medlabprojects/MCB_Daughterboard_ESCON-24-2/Daughter_ESCON_24-2.brd

## EAGLE design Daughter_ESCON_24-2.brd (2019-08-14)

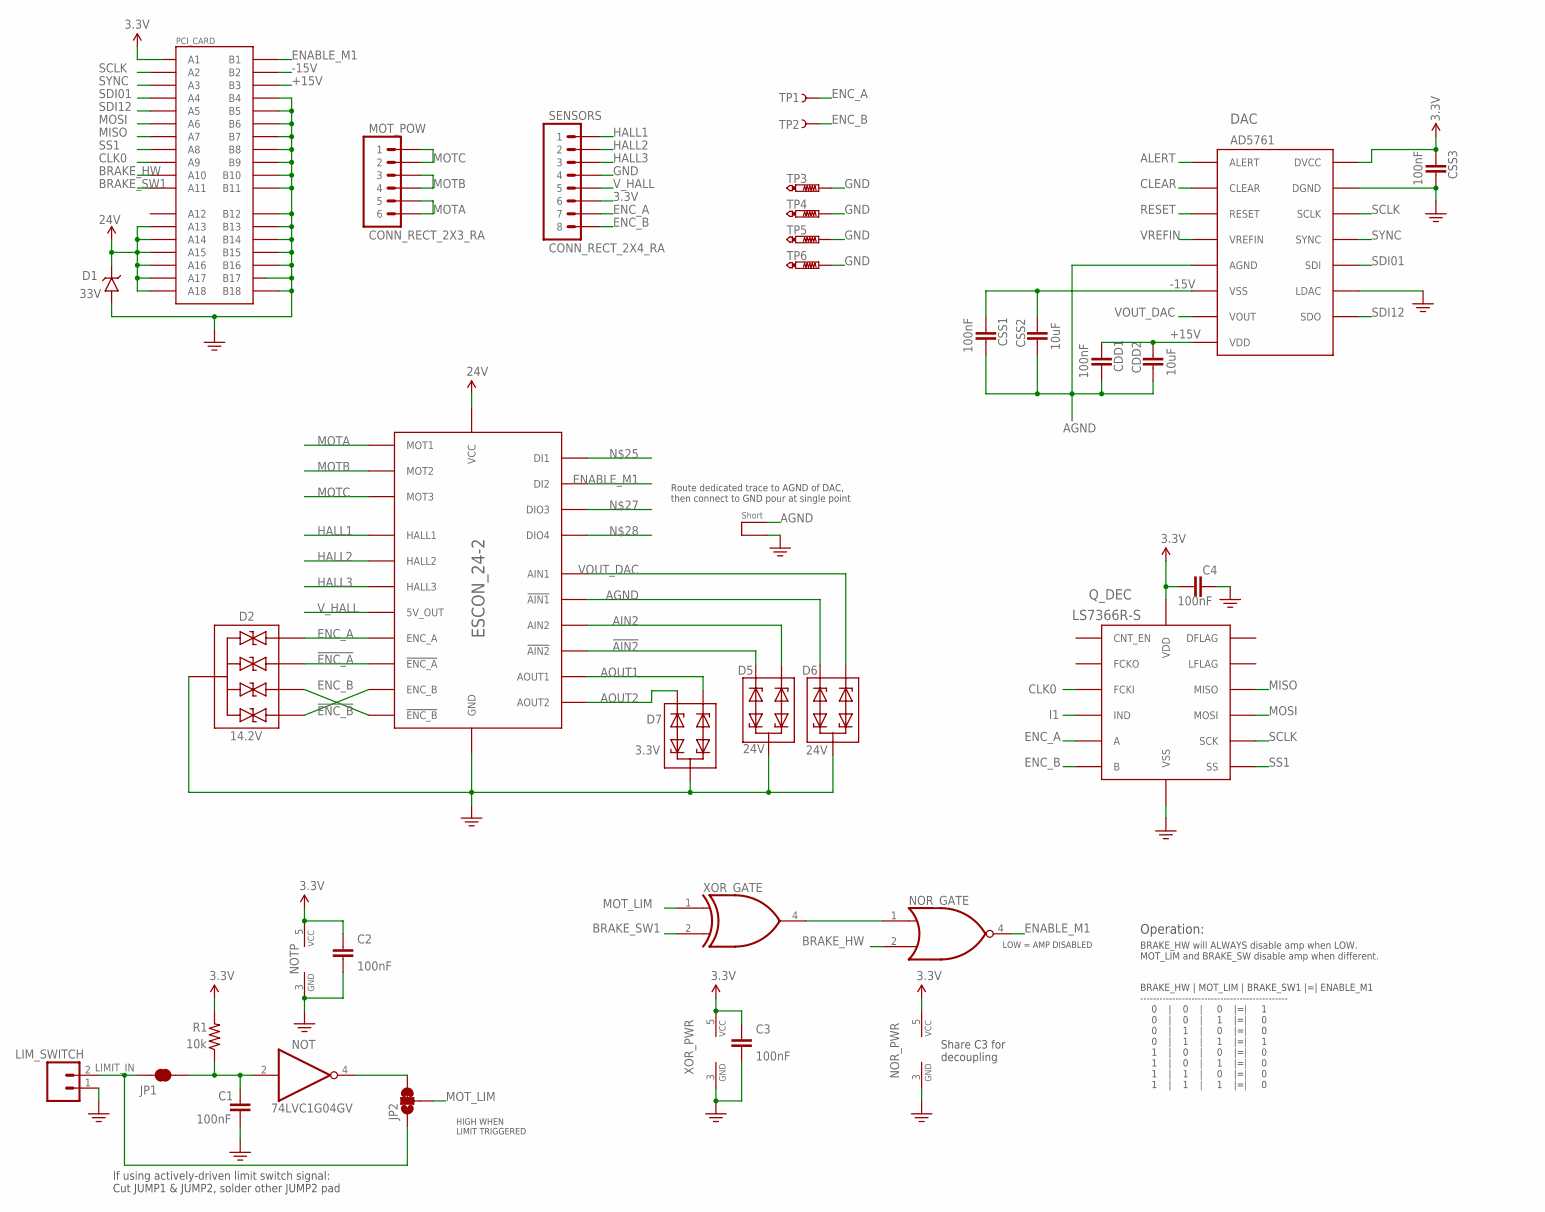
[picture p1: schematic Daughter_ESCON_24-2.sch]

Parts:
C1, C2, C3, C4: 100nF; 0603-CAP
CDD1: 100nF; 0603-CAP
CDD2: 10uF; C0805K
CSS1, CSS3: 100nF; 0603-CAP
CSS2: 10uF; C0805K
D1: 33V; DO214AA
D2: 14.2V; SOTFL50P160X60-6
D5, D6: 24V; SOT95P230X110-3
D7: 3.3V; SOT95P230X110-3
DAC: AD5761; TSSOP16
ESCON_24-2: ESCON_MODULE24-2_BOTTOM_ENTRY; ESCON_24-2_BOTTOM_ENTRY
JP1: JUMPER-PAD-2-NC_BY_TRACE; PAD-JUMPER-2-NC_BY_TRACE_YES_SILK
JP2: JUMPER-PAD-3-2OF3_NC_BY_TRACE; PAD-JUMPER-3-2OF3_NC_BY_TRACE_YES_SILK_FULL_BOX
LIM_SWITCH: 22-05-7028-02; 7395-02
MOT_POW: CONN_RECT_2X3_RA; 2X3-RA
NOR: NOR-SOT353; SOT353
NOT: 74LVC1G04GV; SOT23-5
PCI_CARD: PCIE-36-EDGE
Q_DEC: LS7366R-S; SOIC-14
R1: 10k; 0603-RES
SENSORS: CONN_RECT_2X4_RA; 2X4-RA
TP1, TP2: TEST-POINT_5021
TP3, TP4, TP5, TP6: PTR1TP20R; TP20R
U$1: SHORT
XOR: XOR-SOT353; SOT353

Connections:
3.3V: C2.1, C3.1, C4.1, CSS3.1, DAC.15 (DVCC), NOR.5 (VCC), NOT.5 (VCC), PCI_CARD.A1, Q_DEC.14 (VDD), R1.2, SENSORS.6, XOR.5 (VCC)
24V: D1.C, ESCON_24-2.P$4 (VCC), PCI_CARD.A13, PCI_CARD.A14, PCI_CARD.A15, PCI_CARD.A16, PCI_CARD.A17, PCI_CARD.A18
!AIN2: D5.1 (2), ESCON_24-2.P$21 (!AIN2)
!ENC_A: D2.3 (IO2), ESCON_24-2.P$11 (!ENC_A)
!ENC_B: D2.4 (IO3), ESCON_24-2.P$13 (!ENC_B)
+15V: CDD1.1, CDD2.1, DAC.8 (VDD), PCI_CARD.B3
-15V: CSS1.1, CSS2.1, DAC.6 (VSS), PCI_CARD.B2
AGND: CDD1.2, CDD2.2, CSS1.2, CSS2.2, D6.1 (2), DAC.5 (AGND), ESCON_24-2.P$23 (!AIN1), U$1.P$1
AIN2: D5.2 (1), ESCON_24-2.P$22 (AIN2)
ALERT: DAC.1 (ALERT)
AOUT1: D7.2 (1), ESCON_24-2.P$20 (AOUT1)
AOUT2: D7.1 (2), ESCON_24-2.P$19 (AOUT2)
BRAKE_HW: NOR.2 (B), PCI_CARD.A10
BRAKE_SW1: PCI_CARD.A11, XOR.2 (B)
CLEAR: DAC.2 (CLEAR)
CLK0: PCI_CARD.A9, Q_DEC.2 (FCKI)
ENABLE_M1: ESCON_24-2.P$16 (DI2), NOR.4 (Y), PCI_CARD.B1
ENC_A: D2.1 (IO1), ESCON_24-2.P$10 (ENC_A), Q_DEC.12 (A), SENSORS.7, TP1.P$1
ENC_B: D2.6 (IO4), ESCON_24-2.P$12 (ENC_B), Q_DEC.11 (B), SENSORS.8, TP2.P$1
GND: C1.2, C2.2, C3.2, C4.2, CSS3.2, D1.A, D2.2 (GND), D2.5 (GND), D5.3, D6.3, D7.3, DAC.11 (LDAC), DAC.16 (DGND), ESCON_24-2.P$5 (GND), ESCON_24-2.P$18 (GND), LIM_SWITCH.1, NOR.3 (GND), NOT.3 (GND), PCI_CARD.B4, PCI_CARD.B5, PCI_CARD.B6, PCI_CARD.B7, PCI_CARD.B8, PCI_CARD.B9, PCI_CARD.B10, PCI_CARD.B11, PCI_CARD.B12, PCI_CARD.B13, PCI_CARD.B14, PCI_CARD.B15, PCI_CARD.B16, PCI_CARD.B17, PCI_CARD.B18, Q_DEC.3 (VSS), SENSORS.4, TP3.TP, TP4.TP, TP5.TP, TP6.TP, U$1.P$2, XOR.3 (GND)
HALL1: ESCON_24-2.P$7 (HALL1), SENSORS.1
HALL2: ESCON_24-2.P$8 (HALL2), SENSORS.2
HALL3: ESCON_24-2.P$9 (HALL3), SENSORS.3
I1: Q_DEC.10 (IND)
LIMIT_IN: JP1.1, JP2.1, LIM_SWITCH.2
MISO: PCI_CARD.A7, Q_DEC.6 (MISO)
MOSI: PCI_CARD.A6, Q_DEC.7 (MOSI)
MOTA: ESCON_24-2.P$1 (MOT1), MOT_POW.5, MOT_POW.6
MOTB: ESCON_24-2.P$2 (MOT2), MOT_POW.3, MOT_POW.4
MOTC: ESCON_24-2.P$3 (MOT3), MOT_POW.1, MOT_POW.2
MOT_LIM: JP2.2, XOR.1 (A)
unnamed: C1.1, JP1.2, NOT.2 (I), R1.1
unnamed: JP2.3, NOT.4 (O)
unnamed: NOR.1 (A), XOR.4 (Y)
RESET: DAC.3 (RESET)
SCLK: DAC.14 (SCLK), PCI_CARD.A2, Q_DEC.5 (SCK)
SDI01: DAC.12 (SDI), PCI_CARD.A4
SDI12: DAC.10 (SDO), PCI_CARD.A5
SS1: PCI_CARD.A8, Q_DEC.4 (SS)
SYNC: DAC.13 (SYNC), PCI_CARD.A3
VOUT_DAC: D6.2 (1), DAC.7 (VOUT), ESCON_24-2.P$24 (AIN1)
VREFIN: DAC.4 (VREFIN)
V_HALL: ESCON_24-2.P$6 (5V_OUT), SENSORS.5

Notes on the sheet:
HIGH WHEN LIMIT TRIGGERED
LOW = AMP DISABLED
Operation:
BRAKE_HW will ALWAYS disable amp when LOW. MOT_LIM and BRAKE_SW disable amp when different.
BRAKE_HW | MOT_LIM | BRAKE_SW1 |=| ENABLE_M1 ---------------------------------------------- 0 | 0 | 0 |=| 1 0 | 0 | 1 |=| 0 0 | 1 | 0 |=| 0 0 | 1 | 1 |=| 1 1 | 0 | 0 |=| 0 1 | 0 | 1 |=| 0 1 | 1 | 0 |=| 0 1 | 1 | 1 |=| 0
If using actively-driven limit switch signal: Cut JUMP1 & JUMP2, solder other JUMP2 pad
Route dedicated trace to AGND of DAC, then connect to GND pour at single point
Share C3 for decoupling

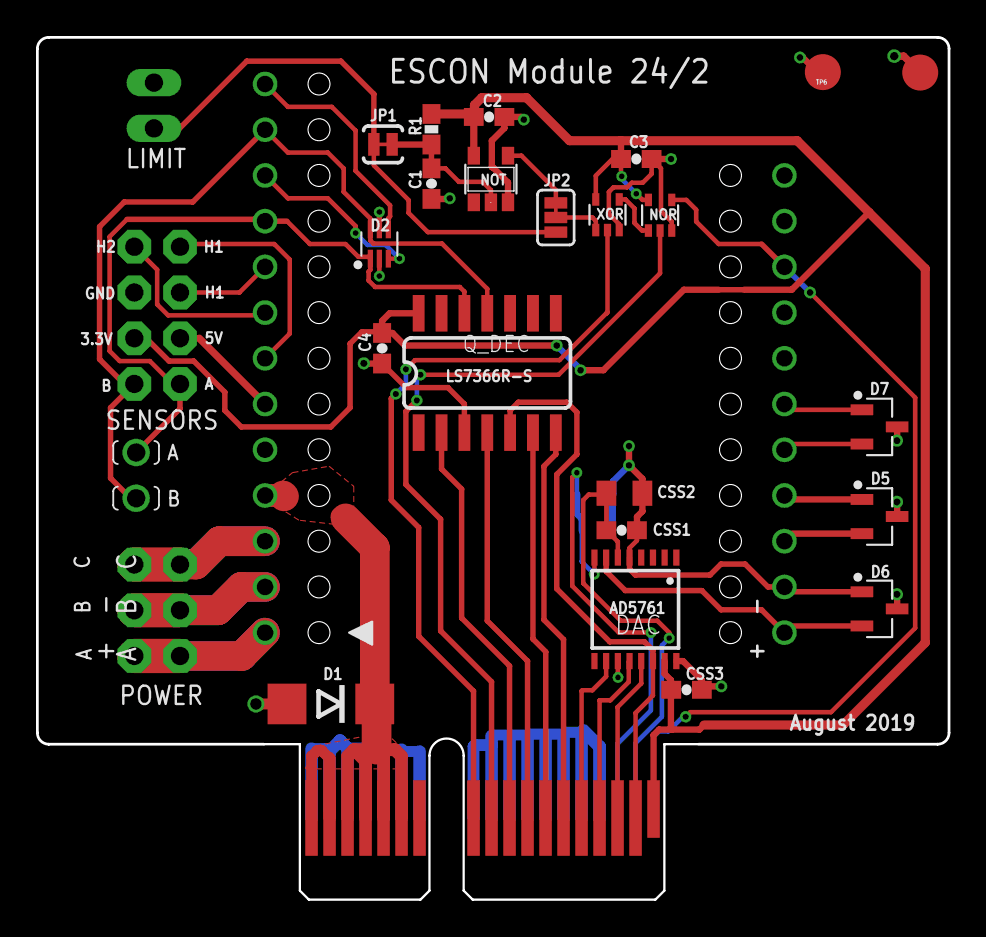
[picture p2: board Daughter_ESCON_24-2.brd from above]

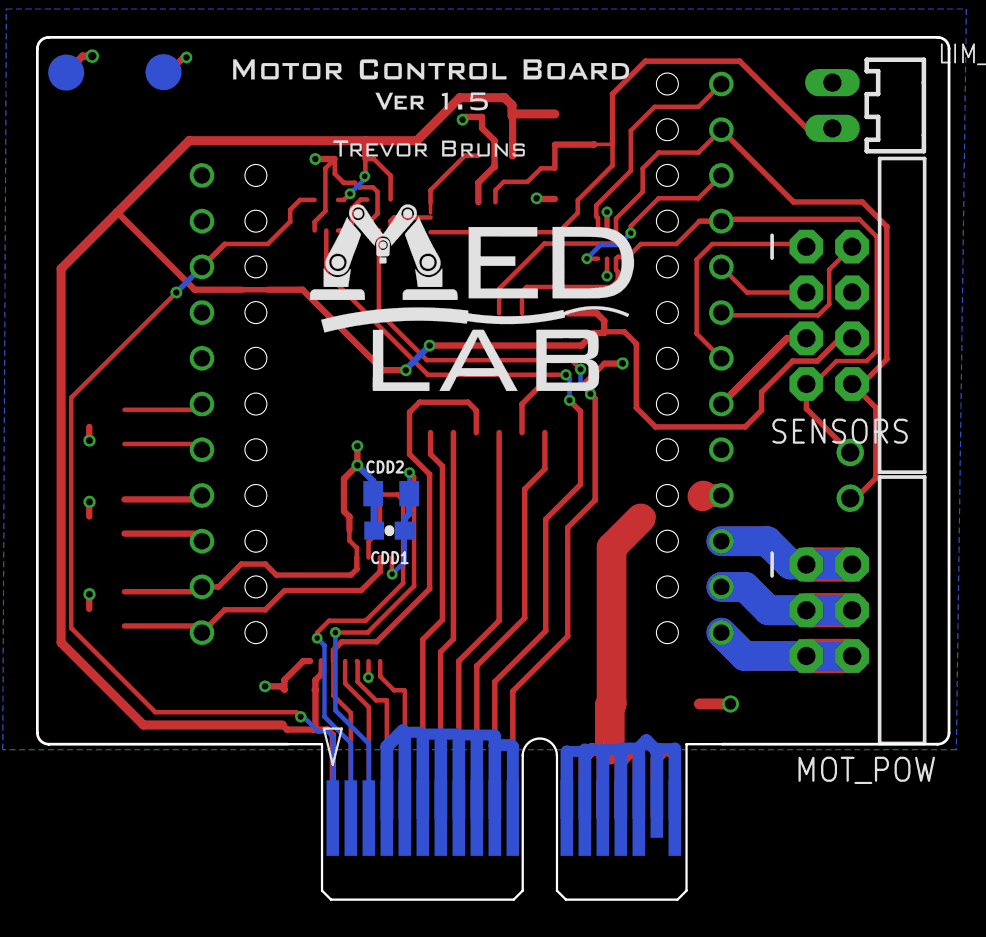
[picture p3: board Daughter_ESCON_24-2.brd from below]

Board: 2 copper layers, 50.6 x 47.9 mm, 36 parts (11 on the bottom side), 38 nets.

Other parts of the board:
U$3: LOGO_MEDLAB_0.7X0.4
U$4: LOGO_MOTOR_CONTROL_1.5_SMALL
