medlabprojects/MCB_Daughterboard_ESCON-24-2/(commit log)

2018-10-30 Added initial files
    [Daughter_ESCON_24-2.brd, Daughter_ESCON_24-2.sch]
2018-11-01 Protection circuitry added but not routed
    [Daughter_ESCON_24-2.brd, Daughter_ESCON_24-2.sch]
2018-11-04 Finished and generated gerbers
    [Daughter_ESCON_24-2.brd, Daughter_ESCON_24-2.sch]
2019-08-14 Replaced 3.3V TVS with larger package
    [Daughter_ESCON_24-2.brd, Daughter_ESCON_24-2.sch]
